beliciobcardoso/robo_bipede/docs/arquitetura_perna.md

# Arquitetura da perna

> Status: **em construção.** As faixas das juntas abaixo são **provisórias** — serão validadas
> na F5 (passada na simulação). As medidas da perna saem da F2.

## Juntas (por perna)

| # | Junta | Eixo | Gira para |
|---|---|---|---|
| 1 | Quadril | pitch | frente / trás |
| 2 | Joelho | pitch | dobrar / esticar |
| 3 | Tornozelo | pitch | ponta do pé para cima / baixo |
| 4 | Tornozelo | roll | inclinar para o lado |

## Batentes e limites de software

Toda junta tem **dois limites**:

1. **Batente mecânico** — um ressalto desenhado na própria peça impressa, onde as duas peças da
   junta encostam e param. Protege o servo: em queda ou empurrão o impacto vai para o plástico
   impresso, e não para o batente interno e a engrenagem plástica do SG90.
2. **Limite de software** — no firmware (e na simulação), **5° antes do batente**. O motor nunca
   é mandado além dele, então **nunca empurra o batente**. Servo forçando parado puxa ~0,7 A,
   esquenta e desgasta.

| Junta | Batente mecânico | Limite de software | Observação |
|---|---|---|---|
| Quadril pitch | −30° a +90° | −25° a +85° | +90° = coxa para frente (agachar, subir degrau) |
| Joelho | −120° a +5° | −115° a 0° | só dobra para um lado; batente em +5° impede o joelho de dobrar ao contrário |
| Tornozelo pitch | −45° a +45° | −40° a +40° | limita o agachamento mais fundo (40°) |
| Tornozelo roll | −30° a +30° | −25° a +25° | inclinação lateral para jogar o peso de um pé para o outro |

Convenção de sinal (simulação): agachar é quadril **+**, joelho **−**, tornozelo pitch **+**.

### Regras de projeto do batente

- O batente fica **na peça impressa**, nas duas partes da junta (um ressalto que encosta numa face).
- **Superfície de contato larga e parede grossa** no ponto do batente: ele leva o impacto de
  quedas. Evitar pontas finas ou cantos vivos.
- O batente **não pode depender do servo**: com o servo desmontado, a junta já deve parar no limite.
- O servo é montado com o horn **centralizado** de forma que o curso do servo (~180°) cubra a
  faixa inteira da junta com folga — o batente da peça chega antes do batente interno do servo.
- Na calibração do firmware, encostar a junta à mão no batente serve de referência para achar o
  zero de cada servo.

### O que a simulação já mostrou (modelo de caixinhas, F0)

- Agachando devagar com a regra quadril = A, joelho = −2A, tornozelo = A, o limite é o
  **software do tornozelo em 40°**, com o joelho fazendo 0,067 N·m (37 % do SG90).
- Em operação normal nenhuma junta chega ao batente.

### Deslocar o peso para o lado (resultado da F1)

O robô não tem **quadril roll**. Consequência: com os dois pés no chão, os tornozelos roll ficam
travados, e para apoiar numa perna o **corpo inteiro inclina para o lado** (~18°, faixa estável
10°–26° no modelo de 359 g com quadris a 55 mm). Quadris mais próximos reduzem essa inclinação.
**Decisão (24/10): manter 8 DOF, sem quadril roll.** O robô apoia numa perna inclinando o corpo
inteiro para o lado (andar "rebolado"). Motivos: menos peças, menos peso e menos servos para
calibrar, e na F1 o SG90 trabalhou com folga nessa postura (joelho 11 %, tornozelo roll 2–32 %).
Consequências para as próximas fases:
- a passada (F5) é do tipo "rebolado": inclina para o lado, levanta o pé de fora, dá o passo;
- a **largura do quadril** é a alavanca para reduzir a inclinação — entra na varredura da F2;
- o **tornozelo roll** é a junta que controla o equilíbrio lateral (pé de apoio).

Condições para manter a decisão:
1. **Balanço lateral em movimento:** o pico do tornozelo roll ao inclinar o corpo de um pé para o
   outro, no ritmo da passada, deve ficar abaixo de **~70 % do SG90**.
2. **Inclinação:** depois de afinar a largura do quadril (F2), a inclinação para apoiar numa
   perna deve ficar abaixo de **~20°**.
3. **Quadril modular:** o suporte do quadril e o tronco reservam espaço para um servo de quadril
   roll de cada lado, para que a mudança, se vier, não obrigue a refazer tronco, capas e fiação.

Se 1 ou 2 falhar, a decisão volta para discussão.

**Situação (24/10):**
- Condição 1 — **passa.** Com as medidas atuais (quadris 50 mm): tornozelo roll 50 % a 0,5 passo/s e 57 % a 1 passo/s. Antes, com quadris a 55 mm, dava apertado: Balanço lateral sem controle: tornozelo
  roll 53 % a 0,5 passo/s e 61 % a 1 passo/s; passa de 70 % só acima disso (85 % a 1,33 passo/s).
  O joelho chega a 69 % a 1 passo/s. Números preliminares: dependem do amortecimento do servo
  (estimado; a F3 mede) e do padrão de movimento (a F5 refina).
- Condição 2 — **passa.** Inclinação para apoiar numa perna: 14° (quadris 50 mm, tornozelo 22 mm).
- Condição 3 — entra no projeto do quadril.

## Medidas da perna

> **Aprovadas em 24/10.** Revisadas no mesmo dia no conceito do suporte (`suporte_servo.md`):
> a perna real tem ~42 mm de largura (pilha horn + servo + rolamento ao longo do eixo), então os
> quadris foram de 45 para **50 mm**, e o tornozelo pitch→roll de 12 para **22 mm**. O modelo
> `sim/models/f1_biped.xml` usa estas medidas.

| Medida | Valor | Por quê |
|---|---|---|
| Distância entre quadris | **50 mm** | Perna de ~42 mm + ~8 mm de folga: cabe capa nas duas faces. A 45 mm sobrariam ~3 mm |
| Largura da perna (estrutura) | ~42 mm | Pilha ao longo do eixo pitch: braço do garfo, horn, servo, fundo do suporte, rolamento |
| Coxa (quadril → joelho) | **45 mm** | Cabe suporte (~24 mm do eixo às costas) + garfo (~14 mm do eixo à base) + junção |
| Canela (joelho → tornozelo) | **45 mm** | Idem; coxa = canela simplifica a cinemática inversa (F5) |
| Tornozelo pitch → roll | **22 mm** | Garfo do tornozelo pitch + suporte do servo roll, numa peça única |
| Pé | **45 × 70 mm** | Largura = quadris − 5 mm, para os pés não se tocarem |
| Massa das capas | **meta 35 g, limite 50 g no total** | Validado a 1 passo/s com 50 g (tronco 20 g + 15 g por perna) |

Altura do centro do tronco em pé: ~158 mm. Massa total estimada: 359 g só com as pernas; **615 g**
com cabeça, braços de 4 servos, cintura giratória, LiPo de 55 g e capas de 0,8 mm (revisão de 25/10, ver
[arquitetura_corpo.md](arquitetura_corpo.md)). Centro do tronco em pé: ~170 mm.

Robô atual na simulação (aberto, sem controle de equilíbrio):

| Teste | Resultado |
|---|---|
| Ficar numa perna | inclinação de **14°** (faixa estável 8–20°); joelho 11 %, tornozelo roll até 40 % nas bordas |
| Balanço lateral a 0,5 passo/s | tornozelo roll **50 %**, joelho 36 % |
| Balanço lateral a 1 passo/s | tornozelo roll **57 %**, joelho 69 % |
| Levantar de 34° em 0,6 s | joelho 53 % |
