beliciobcardoso/robo_bipede/docs/medidas_horn_sg90.md

# Medidas do horn do SG90 (braço simples)

O **horn** é a pecinha de plástico branco que encaixa no eixo do servo. O garfo do suporte vai ter
um **rebaixo no formato exato do horn** — o formato é que transmite a força para a perna — então
preciso das medidas do seu.

Use o horn de **braço simples** (um braço só, como uma colher). Preencha a coluna **Medido** em mm.
Os valores "típicos" são de catálogo, só para você ter ideia da ordem de grandeza.

## Vocabulário

| Palavra | O que é |
|---|---|
| **Cubo** | a parte redonda do horn, que encaixa no eixo dentado do servo |
| **Braço** | a parte comprida que sai do cubo |
| **Furos do braço** | os furinhos ao longo do braço |

```
 vista de cima                           vista de lado

        ┌──────────────────────┐              ┌────┐  ← cubo (mais alto)
  ┌───┐ │ ○    ○    ○    ○    ○ │ ← braço      │    │━━━━━━━━━━━━━━━━━━━┓ ← braço (fino)
  │ ● │─┤                      │              └────┘
  └───┘ └──────────────────────┘
  cubo  │←─────── comprimento ──────→│
        (do centro do cubo até a ponta)
```

## Cubo

| # | Medida | Como medir | Típico | Medido |
|---|---|---|---|---|
| 1 | Diâmetro do cubo | por fora, a parte redonda | 7,0 | |
| 2 | Altura do cubo | da face de baixo até a de cima do cubo | 4,0 | |
| 3 | Diâmetro do furo do parafuso central | o furo no meio do cubo, por cima | 2,0 | |

## Braço

| # | Medida | Como medir | Típico | Medido |
|---|---|---|---|---|
| 4 | Comprimento total | do **centro** do cubo até a ponta do braço | 18 | |
| 5 | Largura do braço junto ao cubo | onde o braço encontra o cubo | 6,0 | |
| 6 | Largura do braço na ponta | na ponta | 4,0 | |
| 7 | Espessura do braço | de cima a baixo, no meio do braço | 1,5 | |
| 8 | Ponta do braço | é arredondada ou reta? | arredondada | |

## Furos do braço

| # | Medida | Como medir | Típico | Medido |
|---|---|---|---|---|
| 9 | Quantos furos | contar | 5 ou 6 | |
| 10 | Diâmetro de um furo | | 1,0 | |
| 11 | Do centro do cubo até o primeiro furo | centro a centro | 6 | |
| 12 | Entre dois furos vizinhos | centro a centro | 2,5 | |

## Montado no servo

| # | Medida | Como medir | Típico | Medido |
|---|---|---|---|---|
| 13 | Altura do horn montado | com o horn encaixado no servo: da **base do servo** até o **topo do cubo** | 32 | |
| 14 | Altura do braço montado | idem, até a face de **cima do braço** | 30 | |

As medidas **1, 2, 4, 5, 7 e 13** são as mais importantes: elas definem o rebaixo e a altura do
braço do garfo.
