beliciobcardoso/robo_bipede/docs/lista_materiais.md

# Lista de materiais e ferramentas

Marque `[x]` no que já tem. Itens **(opcional)** não bloqueiam o projeto.

Massa total: **615 g** (288 mm de altura, 17 servos com a cintura, capas de 0,8 mm de 133 g calculadas
pela forma, tronco em V — 25/10). **SG90 em todas as juntas** (decisão de
24/10): joelho e tornozelo roll ficam no limite a 1 passo/s e com folga a 0,5 passo/s — ver
[arquitetura_corpo.md](arquitetura_corpo.md).

> **Configuração: 17 servos SG90** (16 + 1 na cintura, 25/10) — por perna: quadril pitch, joelho, tornozelo pitch, tornozelo roll;
> por braço: ombro pitch, ombro roll, cotovelo, punho (gira). Mão fixa. Cabeça fixa com o sensor
> ultrassônico (aprovado em 24/10).

## Atuadores

- [ ] **Servo SG90 (clone)** — 8 — juntas das pernas (você tem 4 em mãos, 25/10)
- [ ] **Servo SG90 (clone) para os braços** — 8 — ombro pitch, ombro roll, cotovelo e punho de cada
  braço; comprar também reservas novas (as atuais não devem virar servo de braço)
- [ ] **Servo SG90 (clone) para a cintura** — 1 — gira o tronco ±45° sobre o quadril (decidido em 25/10)
- [ ] **Servo SG90 reserva** — 2 a 4 — engrenagem plástica de clone espana; ter reserva evita parar o projeto
- [X] **Horns** (braço simples e cruz) — vêm com o servo — fixação no eixo
- [X] **Parafusos do servo** (abas + horn) — vêm com o servo

## Controle e sensores

- [X] **ESP32 DevKit** — 1 — controle, MPU-6050, HC-SR04, Wi-Fi
- [X] **MPU-6050** (acelerômetro + giroscópio 3 eixos) — 1 — equilíbrio; I2C, montar no centro do tronco
- [ ] **PCA9685** (driver PWM 16 canais, I2C) — 1 — no quadril, para os 8 servos das pernas + o da cintura; os 8 dos braços vão direto no LEDC do ESP32 (divisão de 25/10, [alimentacao.md](alimentacao.md))
- [ ] **HC-SR04** (sensor ultrassônico) — 1 — na cabeça, olhando para a frente; ECHO sai em 5 V → divisor resistivo (ex.: 1 kΩ + 2 kΩ) antes do GPIO
- [ ] **ESP32-CAM** **(futuro)** — 1 — câmera na cabeça como placa separada, falando com o ESP32 principal por UART; 10 g já reservados na massa
- [ ] **INA219** (sensor de corrente/tensão I2C) **(opcional)** — 1 — medir consumo dos servos, detectar travamento
- [ ] **FSR / sensor de força no pé** **(opcional)** — 2 a 8 — detectar contato do pé com o chão
- [X] **Buzzer + LED de status** **(opcional)** — 1 — feedback de estado e bateria fraca

## Alimentação

Corrente dos servos ([alimentacao.md](alimentacao.md), 25/10): andando, pico < 2,5 A; queda ou trava
~6 A; ligar os 16 de uma vez ~12 A — o firmware liga em grupos para não chegar lá. Medir o real com o
INA219 na F3.

- [X] **Bateria 2S (7,4 V)** — 1 — **LiPo 2S ~800 mAh, ~55 g** (decidido em 24/10: com braços, as
  2× 18650 de ~95 g tiram a margem do tornozelo roll). Se o que você tem são 18650, desmarque e compre a LiPo
- [ ] **Pack 2S1P 14500 alta descarga (IMR), soldado a ponto** — 1 — para testar contra a LiPo (25/10); células sem proteção interna, marca com teste publicado, ≥ 5 A contínuos, 700–800 mAh reais (ignorar "1200 mAh")
- [X] **BMS 2S** — 1 — no pack 2S1P 14500: com balanceamento, sobrecorrente ≥ 8–10 A
- [ ] **Regulador dos servos: UBEC 5 V / 7 A genérico (2S–6S, 16 g)** **(comprado em 25/10, aguardando entrega)** — 1 — [anúncio de R$ 59](https://www.mercadolivre.com.br/ubec-5v-7a-de-2s-a-6s-p-drone-automodelo-ou-aeromodelo/up/MLBU3810590864); trocado do Pololu D24V150F5 por custo (25/10) — trilho único dos 16 servos (trilho separado para os braços não compensa a fiação extra); decidido em 25/10 no lugar do UBEC e do D24V90F5 ([alimentacao.md](alimentacao.md))
- [ ] **Regulador da lógica: módulo MP1584EN (step-down 3 A, ajustável)** **(comprado em 25/10, kit de 5, aguardando entrega)** — 1 (+4 reservas) — [anúncio](https://www.mercadolivre.com.br/5-buck-conversor-mp1584en-step-down-dc-dc-3a-ajustavel/p/MLB2088650164); no lugar do Pololu D24V10F5, por custo; ajustar em 5,0 V e travar o trimpot — ESP32, PCA9685 (lógica), MPU-6050 e HC-SR04 direto da bateria, fora do trilho dos servos: um stall derruba o trilho sem reiniciar o ESP32 (decidido em 25/10). Não tem proteção contra inversão — fica depois da chave e do conector polarizado
- [X] **Capacitor eletrolítico 470–1000 µF / 16 V** — 2 — junto ao trilho dos servos, segura queda nos picos
- [X] **Chave liga/desliga ≥ 5 A** — 1 — fica do lado da bateria, junto do fusível: conferir se aguenta 7,5 A
- [ ] **Fusível 7,5 A de ação retardada** — 1 — proteção da bateria, dimensionado pela corrente que sai dela (~5 A numa queda a 7,4 V); decidido em 25/10. O de 5 A que você tem não serve com 16 servos
- [X] **Divisor resistivo para medir bateria** (ex.: 100 kΩ + 33 kΩ) — 1 — ADC do ESP32, corte por subtensão
- [X] **Carregador balanceado 2S** (ou carregador 18650) — 1
- [X] **Conector de bateria XT30** — 1 par por pack + 1 no robô — padrão das duas baterias (25/10); balanceamento em JST-XH 3 pinos nos dois packs, para o mesmo carregador

## Cabeamento e montagem eletrônica

- [X] **Extensão de cabo de servo 15–30 cm** — 4 a 8 — servos do joelho e tornozelo até o tronco (+6 para ombro roll, cotovelo e punho)
- [X] **Barra de pinos macho 3 vias** — para placa de distribuição dos servos
- [X] **Placa perfurada** (ou PCB própria) — 1 — distribuição de alimentação + ESP32 + MPU
- [X] **Fio silicone 18–20 AWG** — trilho de potência
- [X] **Fio fino / jumpers Dupont** — sinais
- [X] **Conectores JST-XH ou Dupont + crimpador**
- [X] **Termorretrátil**
- [X] **Abraçadeiras pequenas / espiral organizadora**

## Mecânica e fixação

- [ ] **Filamento PETG** (ou PLA) — 1 rolo — PETG aguenta melhor impacto de queda
- [ ] **Rolamento 623ZZ (3×10×4 mm, aço carbono)** **(comprado, aguardando entrega)** — 8 (+2 reserva) — pivô do lado oposto ao eixo do servo; sem isso a junta fica em balanço e força o servo
- [ ] **Parafusos M3** (8, 10, 12, 16 mm) — eixos de pivô e estrutura
- [ ] **Porcas M3 autotravantes (nylon)** — pivôs não soltam com vibração
- [ ] **Arruelas M3**
- [ ] **Parafusos M2** (6, 8 mm) + porcas — fixações pequenas
- [ ] **Insertos roscados M2/M3 a quente** **(comprado em 25/10, aguardando entrega)** — kit de 400: M2 × 2–6 mm (OD 3,5) e M3 × 3–8 mm (OD 4,2) — necessário: pino do pivô e união suporte + garfo (M3), placas (M2); furo conforme o vendedor (~4,0 mm para OD 4,2), parede ≥ 1,5–2 mm em volta
- [ ] **Borracha antiderrapante para a sola** — 2 — EVA, borracha de câmara ou TPU impresso

## Ferramentas

- [ ] **Impressora 3D**
- [X] **Paquímetro**
- [X] **Multímetro**
- [X] **Fonte de bancada com limite de corrente** — primeiros testes sem risco para servos e bateria
- [X] **Ferro de solda + estanho + fluxo**
- [X] **Chaves Phillips PH00 / PH0**
- [X] **Chaves Allen / chave de boca 5,5 mm (M3)**
- [X] **Alicate de corte e desencapador**
- [X] **Testador de servo** **(opcional)** — centralizar servo antes de montar o horn
- [ ] **Analisador lógico / osciloscópio** **(opcional)** — depurar PWM e I2C

## Software

- [x] **FreeCAD 1.1** — modelagem
- [ ] **Fatiador** (OrcaSlicer, PrusaSlicer ou Cura)
- [x] **Arduino IDE 2** — já instalado; alternativa: PlatformIO
- [ ] **Biblioteca do MPU-6050** (Electronic Cats MPU6050 / i2cdevlib, com DMP)
- [X] **Git** — versionar scripts CAD e firmware
