beliciobcardoso/robo_bipede/cad/manual/servo_sg90.FCStd

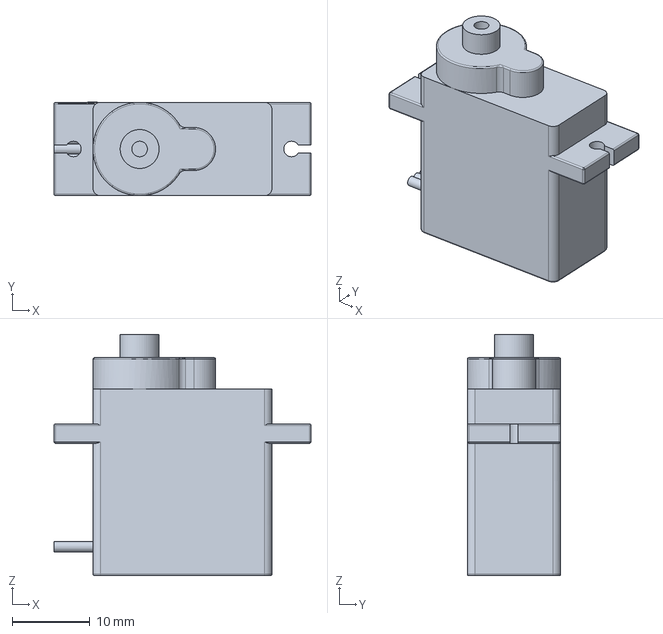
[picture p4: CAD file, 2026-10-24]
cad/manual/servo_sg90.FCStd
33.0 x 12.0 x 31.0 mm
