beliciobcardoso/robo_bipede/sim/models/meshes/servo_sg90.stl

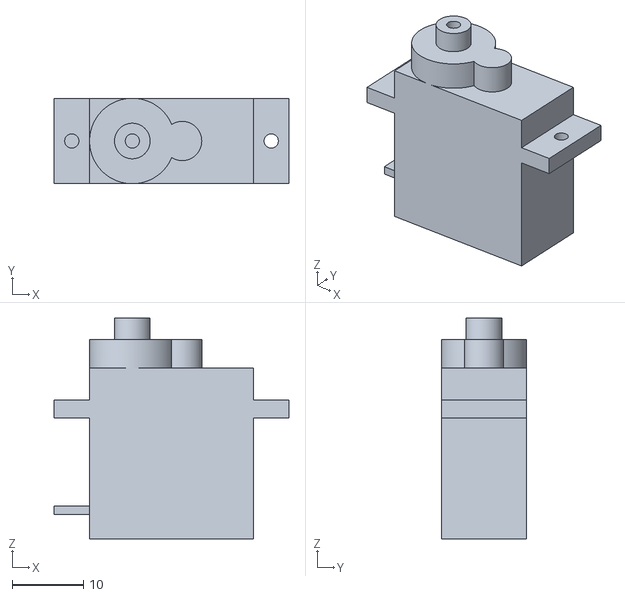
[picture p5: CAD file, 2026-10-24]
sim/models/meshes/servo_sg90.stl
33.0 x 12.0 x 31.0
