beliciobcardoso/robo_bipede/sim/models/meshes/bearing_623zz.stl

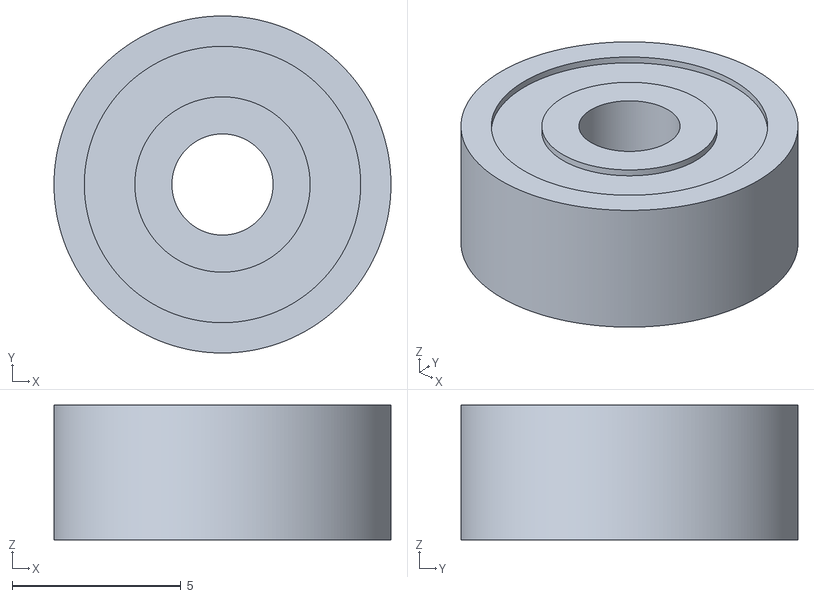
[picture p6: CAD file, 2026-10-24]
sim/models/meshes/bearing_623zz.stl
10.0 x 10.0 x 4.00
