beliciobcardoso/robo_bipede/sim/results/body_variants.csv

proporcao | parede_mm | massa_g | capas_g | altura_mm | head_pct_altura | torso_pct_altura | legs_pct_altura | dist_alpha | uma_perna | roll_teste_graus | balanco_0.5_faixa | roll_0.5_pct | joelho_0.5_pct | balanco_1.0_faixa | roll_1.0_pct | joelho_1.0_pct | levantar_joelho_pct | pior_pico_pct | passa
t68_o86_cG | 1.2 | 518 | 164 | 254 | 20 | 31 | 50 | 3.0 | -14 a -10° | 12 | 10-12 | 64 | 43 | 10-12 | 70 | 70 | 67 | 70 | True
t60_o70_cG | 0.8 | 451 | 103 | 246 | 20 | 28 | 51 | 4.5 | -16 a -8° | 12 | 10-14 | 59 | 36 | 10-12 | 62 | 68 | 62 | 68 | True
t60_o86_cG | 0.8 | 457 | 106 | 246 | 20 | 28 | 51 | 4.5 | -16 a -8° | 12 | 10-14 | 60 | 36 | 10-12 | 63 | 68 | 62 | 68 | True
t60_o70_cM | 0.8 | 449 | 101 | 238 | 18 | 29 | 53 | 6.8 | -16 a -8° | 12 | 10-14 | 59 | 36 | 10-12 | 62 | 68 | 61 | 68 | True
t60_o86_cM | 0.8 | 454 | 103 | 238 | 18 | 29 | 53 | 6.8 | -16 a -8° | 12 | 10-14 | 59 | 36 | 10-12 | 62 | 68 | 62 | 68 | True
t68_o70_cP | 1.0 | 478 | 127 | 236 | 14 | 33 | 53 | 10.3 | -16 a -8° | 12 | 10-12 | 61 | 36 | 10-12 | 70 | 70 | 63 | 70 | True
t68_o86_cP | 0.8 | 458 | 104 | 236 | 14 | 33 | 53 | 10.3 | -16 a -8° | 12 | 10-12 | 60 | 36 | 10-12 | 70 | 70 | 62 | 70 | True
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
