beliciobcardoso/robo_bipede/sim/results/f2_sweep.csv

thigh_mm | shin_mm | hip_spacing_mm | foot_width_mm | covers | mass_g | rise_knee_pct | rise_fell | tilt_needed_deg | tilt_lo | tilt_hi | stance_worst_pct | com_height_mm | shift05_pct | shift10_pct | pass_05 | pass_10 | worst_pct_at_1step
35 | 35 | 40 | 35.0 | nominais | 359 | 48.6 | False | 16.0 | -22.0 | -8.0 | 8.4 | 84.9 | 43.8 | 58.0 | True | True | 58.0
35 | 35 | 40 | 35.0 | pesadas | 409 | 50.2 | False | 16.0 | -22.0 | -8.0 | 9.2 | 83.8 | 49.8 | 65.5 | True | True | 65.5
35 | 35 | 45 | 40.0 | nominais | 359 | 48.6 | False | 16.0 | -24.0 | -10.0 | 8.4 | 84.9 | 48.8 | 63.1 | True | True | 63.1
35 | 35 | 45 | 40.0 | pesadas | 409 | 50.2 | False | 18.0 | -24.0 | -10.0 | 9.1 | 83.8 | 56.1 | 74.0 | True | False | 74.0
35 | 35 | 50 | 45.0 | nominais | 359 | 48.6 | False | 18.0 | -24.0 | -10.0 | 8.3 | 84.9 | 54.4 | 70.7 | True | False | 70.7
35 | 35 | 50 | 45.0 | pesadas | 409 | 50.2 | False | 18.0 | -24.0 | -10.0 | 9.2 | 83.8 | 61.8 | 80.0 | True | False | 80.0
35 | 35 | 55 | 45.0 | nominais | 359 | 48.6 | False | 20.0 | -24.0 | -12.0 | 8.2 | 84.9 | 60.0 | 78.4 | False | False | 78.4
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
