beliciobcardoso/robo_bipede/sim/results/f2_sweep.png

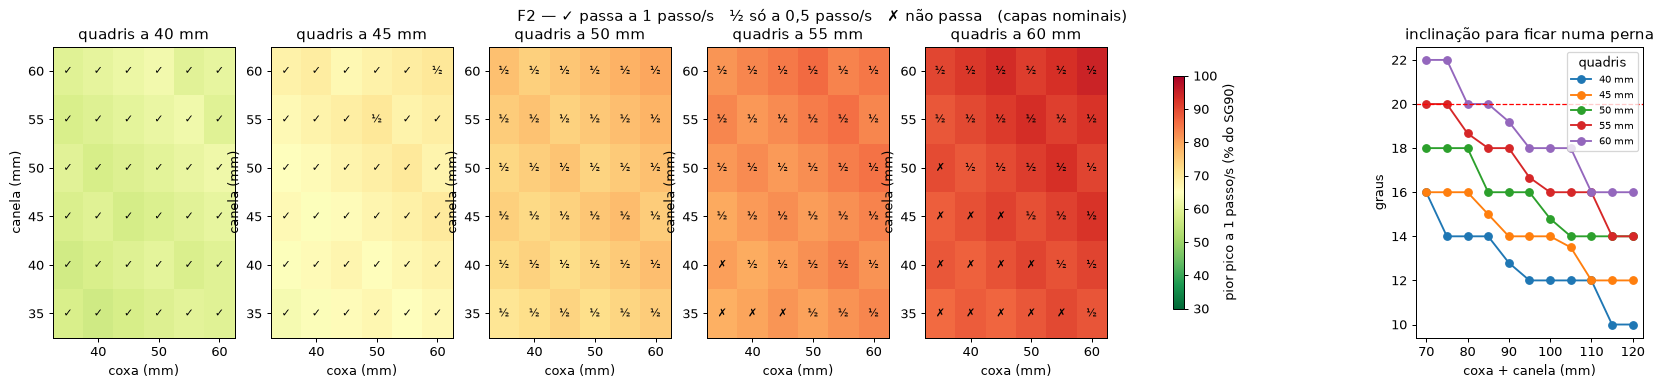
sim/results/f2_sweep.png
