beliciobcardoso/robo_bipede/(commit log)

2026-10-23 adiciona arquivos de configuração CAD, documentação e modelo do servo SG90
2026-10-23 corrige medidas do servo SG90 no documento de especificações
2026-10-23 adiciona orientações sobre o uso do FreeCAD e estrutura do CAD no arquivo CLAUDE.md; atualiza README.md com informações sobre medidas do servo SG90
2026-10-23 refatora o código do servo SG90 para utilizar funções da biblioteca cadlib e remove funções desnecessárias
2026-10-23 marca itens como concluídos na lista de materiais e ferramentas
2026-10-23 feat: add 623ZZ bearing reference model and shared cadlib helpers
    - cad/cadlib.py: CSG primitive helpers (box, cylinder, tube, cut, fuse)
    and export_part (recompute, validate single solid, write FCStd + STEP).
    servo_sg90.py already imports it, so this also fixes the build on main.
    - cad/parts/bearing_623zz.py: 3x10x4 ZZ bearing with ring lands, recessed
    shields and abutment limits (da min / Da max) for housing/spacer design.
    - Makefile: rebuild parts when cadlib.py changes.
    - README/CLAUDE.md: document cadlib and the bearing pivot convention.
2026-10-23 docs: add step-by-step PartDesign tutorial for the SG90 servo
    Hand-modelling guide for FreeCAD 1.1: Body, fully constrained sketches,
    Pad/Pocket and Attachment Offset, with values typed directly into the
    constraints (no spreadsheet). Follows the servo coordinate convention so
    the manual model matches the scripted one; output goes to cad/manual/.
2026-10-23 docs: rewrite servo PartDesign tutorial for beginners
    - Exact FreeCAD 1.1 English UI names (e.g. "New Body", "Horizontal
    Dimension", "Circle From Center"); the previous "Create body" did not exist.
    - Vocabulary (line, vertex, origin, sketch, constraint) and a screen map
    before the first step.
    - Every step says what to select, which tool, what value, and what the
    user should see; constraints in Select -> Tool -> Value tables, always
    measured vertex -> origin.
    - Dropped Attachment Offset: every sketch sits on an origin plane and
    the Pad goes straight to the final height (same resulting solid).
    - Troubleshooting table.
2026-10-24 docs: adicionar arquivo do modelo do servo SG90
    [servo_sg90.FCStd]
2026-10-24 feat: apply re-measured servo dimensions and add GPU model comparison
    - servo_sg90.py mirrors the re-measured hand-made model
    (cad/manual/servo_sg90.FCStd): body 23.0 x 12.0 x 24.0, tabs 33.0,
    holes 28.0 apart, gear bump d5.5 at 7.0, shaft screw hole d2.0.
    - Measurement sheet gains a "Remedido (24/10)" column; values in use.
    - tools/export_stl.py: fine STL from any FreeCAD object, read-only on source.
    - tools/compare_meshes.py: volumetric diff of two STLs on the GPU (CuPy) by
    vertical ray casting with exact Z crossings; per-region volumes and XY/XZ/YZ
    maps. Validated against FreeCAD's solid volume.
    - CLAUDE.md: cad/manual/ is read-only for Claude; how to run the comparison.
    - .gitign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
2026-10-24 docs: add project backlog and GPU simulation plan
    - docs/backlog.md: single checklist for the project (purchases, simulation
    F0-F8, CAD, printing, electronics, firmware), each item tagged with who
    does it; already-finished work ticked.
    - docs/simulacao.md: simulation roadmap on the local RTX 3060 - MuJoCo/MJX
    first, own algorithms only where nothing models them (SG90-clone servo
    model, CAD->MJCF bridge, gait generator, IMU filter, design sweeps).
    Status: proposal, pending approval.
    - README/CLAUDE.md: link both; backlog is the single source of progress.
2026-10-24 docs: plan snap-fit covers for the whole skeleton
    - Backlog section 3.1 "Capas encaixadas": cover-mount standard (type,
    dimensions, shared reference model), mass budget, access that covers must
    keep open (ESP32 USB, switch, charging, servo swap), wire routing,
    ventilation, covers per segment, range-of-motion review.
    - Every structural part is only done once it carries the cover mounts; leg
    architecture reserves cover envelope; F2 sweep includes cover mass; the
    tolerance test print includes the snap-fit; final weigh-in with covers.
    - CLAUDE.md: design rule for snap-fit covers.
2026-10-24 feat: set up GPU simulation environment (F0)
    - requirements.txt pins the analysis + simulation stack: MuJoCo 3.17,
    MJX with the Warp backend, JAX 0.12 (CUDA 12), CuPy, NumPy, Matplotlib.
    - sim/models/f0_smoke.xml: torso + one 4-joint leg of boxes (hip pitch,
    knee, ankle pitch, ankle roll) with SG90-like position servos, plus
    light, skybox, checker floor and camera framing so the viewer shows it.
    - sim/tools/smoke_test.py: runs the model on the CPU and in GPU batches
    (JAX and Warp backends), checks the GPU result matches the CPU and
    reports throughput. On the RTX 3060: Warp ~4.7 M steps/s with 16k robots
    (~71x one CPU core, ~20x the JAX backend), identical to the CPU result.
    - War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
    [smoke_test.py]
2026-10-24 docs: add beginner MuJoCo tutorial
    From-zero guide to the MuJoCo viewer for someone who never used a physics
    simulator: what it is, vocabulary (body, joint, actuator, torque, radian),
    a map of the window with the exact panel names, mouse/keyboard controls,
    and step-by-step tasks with what the user should see - move a joint, read
    the knee torque in Watch, and a crouch experiment with expected values
    computed by running the same simulation (0 / 0.02 / 0.04 N.m, falls at
    ~34 deg on one leg). Troubleshooting table. Backlog item to do it.
2026-10-24 feat: add MuJoCo monitor with exact crouch keys, live torque and CSV log
    - sim/tools/monitor.py: same viewer, but keys 1-4 / + / - set the crouch
    depth A exactly (hip = A, knee = -2A, ankle = A), moved at servo-like
    speed with all joints together; live knee torque vs SG90 in the terminal;
    every session logged at 50 Hz to sim/logs/*.csv so Claude can analyse it;
    dragging a Control slider switches to manual mode. --sweep runs every
    depth headless and reports torque, falls and joint-stop hits.
    - Tutorial step 5 rewritten around the monitor, with values from the sweep.
    The earlier "falls at 34 deg" came from jumping to the posture; moving
    slowly it holds up to the software limit.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
2026-10-24 feat: mechanical joint stops with software limits 5 deg inside them
    - Every joint gets a mechanical stop printed in the part plus a software
    limit 5 deg inside it, so the servo is never commanded into the stop
    (stall current, heat) while falls and pushes land on printed plastic, not
    on the SG90's internal stop and plastic gears.
    - Provisional ranges (validated later in sim F5): hip -30..+90, knee
    -120..+5 (bends one way), ankle pitch +-45, ankle roll +-30.
    - f0_smoke.xml: joint range = stop, actuator ctrlrange = software limit.
    Monitor caps the crouch at the software limits (ankle pitch, 40 deg) and
    reports "limite de software" / "NO BATENTE".
    - docs/arquitetura_perna.md (new): r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
2026-10-24 feat: generate whole-biped F1 model and drive it from the monitor
    - sim/tools/build_biped.py: BipedParams (mm, g) -> MJCF for the whole robot
    made of boxes: torso (battery, electronics, structure, cover) and two
    4-joint legs with each SG90 as a 9 g box where it will sit; joint
    stops / software limits from docs/arquitetura_perna.md; IMU site with
    accelerometer, gyro and orientation sensors; per-actuator torque sensors.
    Only feet, torso and floor collide. Default robot: 359 g, 45 mm thigh
    and shin, hips 55 mm apart. F2 sweeps will build variants in memory.
    - sim/models/f1_biped.xml: generated output (do not hand-edit).
    - monitor.py: actuators grouped by joint type (<type>_l / _r),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
    [build_biped.py, monitor.py]
2026-10-24 feat: F1 experiments - rise speed and one-leg stance on the whole biped
    - sim/tools/f1_experiments.py:
    1. stand up from a 34 deg crouch at several speeds: knee peaks 43 % of
    the SG90 in 1.2 s, 71 % in 0.6 s, 100 % in 0.3 s, falls in 0.15 s;
    2. one-leg stance: with no hip roll the ankle rolls are locked while
    both feet are down, so standing on one foot means tilting the whole
    body; starting tilted over the left foot with the right leg lifted it
    stays up between 10 and 26 deg (centre 18 deg), knee 11 %, ankle roll
    2 % (centre) to 32 % (edges).
    - docs: F1 results in simulacao.md, lateral weight-shift consequence in
    arquitetura_perna.md, tutorial step 8 (whole robo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
2026-10-24 fix: fit the monitor status line to the terminal width
    The live line was wider than an 80-column terminal and got cut before the
    torso height. It is now truncated to the terminal width and ordered by
    importance: crouch, knee % of SG90, most loaded joint, alerts (fall, joint
    stop, software limit), then tilt, torso height, mode and time. Tutorial
    example line updated.
    Verified against the user's F1 session log: static knee torques match the
    tutorial table and the 34 deg -> standing peak (43 %) matches the
    f1_experiments rise test at the same speed.
    [monitor.py]
2026-10-24 docs: record the decision to keep 8 DOF and the conditions to revisit it
    User decision (2026-10-24): keep 8 DOF, no hip roll; standing on one foot
    means tilting the whole body (~18 deg, rocking gait). Conditions to keep
    it: ankle-roll peak below ~70 % of the SG90 while rocking at walking pace,
    tilt below ~20 deg after tuning hip width (F2), and a modular hip with room
    for a hip-roll servo per side. Backlog items for the user's ticks, the
    rocking test, the review criterion and the modular hip; CLAUDE.md project
    line notes the decision.
2026-10-24 feat: lateral rocking test and physical servo damping estimate
    - sim/tools/rocking_test.py: open-loop lateral rocking at walking pace
    (shift onto one foot with both ankle rolls, far leg pushes slightly,
    lift and lower the free foot, mirror). No balance feedback. Ankle roll
    peaks 53 % of the SG90 at 0.5 step/s, 61 % at 1 step/s, 85 % at
    1.33 step/s; knee 36 / 69 / 90 %. Free foot lifts ~22 mm. Condition 1
    of the 8-DOF decision passes up to 1 step/s.
    - build_biped.py: joint damping 0.017 N.m.s/rad = SG90 stall torque /
    no-load speed (torque lost with speed), replacing a 0.05 guess that
    inflated moving-torque peaks by up to ~30 points (a 70 g swing leg read
    89 %). F1 model regen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
    [build_biped.py, rocking_test.py]
2026-10-24 feat: F2 design sweep over leg lengths, hip width and cover mass
    - sim/tools/f2_sweep.py: 360 generated robots (thigh and shin 35-60 mm,
    hips 40-60 mm apart, nominal / heavy covers) on all CPU cores in ~12 s.
    Per robot: rise from a 34 deg crouch in 0.6 s (knee peak, sim), one-leg
    stance (tilt where the stance ankle roll works least, sim), and the
    weight-shift torque from physics, m*g*(spacing/2) + I*alpha at 0.5 and
    1 step/s (open-loop rocking is too pattern-sensitive to rank designs;
    the estimate is conservative vs the sim on the F1 robot, 61 vs 53 %).
    Foot width tied to hip spacing - 5 mm so the feet never touch.
    - Hip width dominates: weight-shift torque grows linearly with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
    [f2_sweep.csv]
2026-10-24 feat: adopt the approved leg dimensions (hips 45, thigh = shin = 45 mm)
    User approved (2026-10-24) the F2 proposal: hips 45 mm apart, thigh and
    shin 45 mm between axes, foot 40 x 70 mm, covers target 35 g / limit 50 g
    total (the sweep's nominal covers were 50 g; 35 g is a stricter target).
    BipedParams defaults updated and f1_biped.xml regenerated. On the approved
    robot: one-leg tilt 14 deg (stable 8-20), rocking ankle roll 45 % at
    0.5 step/s and 50 % at 1 step/s, both 8-DOF conditions pass. Docs:
    arquitetura_perna (approved table and results), simulacao (F2 section),
    backlog, tutorial step 8, CLAUDE.md.
2026-10-24 fix: make the F2 sweep independent of the model defaults, LF line endings
    The sweep took the widest foot from BipedParams' default, so adopting the
    approved 40 mm foot silently changed the results for hips 50-60 mm. The
    rule is now explicit (min(45 mm, hip spacing - 5 mm)); rerun gives data
    identical to the original sweep. CSV written with LF line endings.
2026-10-24 docs: cover mount standard - snap-fit clip and locating pins
    - docs/capas.md (new): decision (user, 2026-10-24) to mount every cover
    with cantilever snap-fit clips plus 2 locating pins, printed in PETG,
    no glue; sliding rails and magnets compared, magnets kept as plan B
    (same mount positions). Design rules: clip beam printed flat, flex
    clearance behind it, release point, one shared clip/pin model, validate
    on the tolerance test print first.
    - Approved dimensions: clip L 8, t 1.2, width 4, hook 0.6 mm, 30 / 60 deg
    entry / retention, 0.8 mm flex clearance (strain ~1.7 %, below the ~2 %
    for repeated use of PETG; ~4 N per clip); pin d3.0 in a d3.3 hole,
    3 mm long, 0.5 mm chamfer.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
2026-10-24 fix: let part scripts import each other without re-running their build
    FreeCADCmd runs a script with __name__ equal to its module name, which is
    also what an import gives, so the old guard `__name__ in ("__main__",
    DOC_NAME)` fired on import too: a part importing another part's DIMS
    silently rebuilt and re-exported the imported part. cadlib.run_as_script()
    also checks the script path in sys.argv. Applied to servo_sg90 and
    bearing_623zz (same outputs: volumes unchanged); CLAUDE.md gotcha updated.
2026-10-24 feat: reference model of the cover mount (snap-fit clip + locating pins)
    - cad/parts/snap_clip.py, cover half: vertical side wall with the clip
    beam running horizontally (printed flat) and its hook (30 deg entry,
    60 deg retention), top flange resting on the skeleton, 2 vertical
    locating pins with tip chamfer. Prints the beam strain (1.69 %).
    - cad/parts/snap_socket.py, skeleton half: block with the hook pocket in
    the side face (depth hook + 0.2 = 0.8 mm) and the 2 pin holes in the top
    face. Shares SnapDims and the assembled-position frame; the build
    assembles both halves and fails on overlapping material (check verified
    by forcing a 0.3 mm too-shallow pocket: 2.56 mm3 reported)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
2026-10-24 feat: approve the servo bracket concept and revise leg dimensions
    - docs/suporte_servo.md (new): bracket concept approved by the user
    (2026-10-24). Every pitch joint = standard holder (servo body by its
    tabs, M3 pivot screw into an M3 insert on the servo axis, 0.5 mm spacer
    on the inner ring only) + standard yoke (arm on the horn with a horn-
    shaped recess, arm with the 623ZZ in a 9.9 mm housing and an 8.5 mm
    shoulder on the outer ring only). Segments are holder + yoke bolted
    back to back (24 + 14 = 38 mm fits the 45 mm between axes); the ankle
    block is one special part. Walls 2.0 mm, servo pocket +0.2 mm per side.
    - The real leg is ~42 mm wide along the pitch axes (horn + serv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
2026-10-24 docs: horn measurement sheet and bracket items in the backlog
    - docs/medidas_horn_sg90.md: beginner measurement sheet for the
    single-arm horn (hub, arm, holes, mounted heights) with typical values;
    the yoke's horn recess copies these.
    - Backlog: leg architecture, cover mount standard and bracket concept
    ticked; horn sheet ticked, measuring it is the user's next item; bracket
    work split into holder and yoke parts.
2026-10-24 feat: whole-body model with 3D preview, Alpha-like proportions and 16 SG90
    - 3D preview (make preview): servo/bearing meshes from the CAD scripts,
    bracket concept, concept covers; rendered with and without covers
    to docs/img/previa_robo.png; history in docs/previa.md
    - sim/tools/body.py is the single source of the robot: legs, torso,
    head (HC-SR04 + camera reserve), arms with 4 joints (shoulder pitch,
    shoulder roll, elbow, wrist rotation; fixed hand), servo per joint
    (SG90 everywhere), LiPo 2S
    - cover masses computed from their shape: each cover encloses its own
    skeleton (gap + wall x PETG density + 15 %); cover_check.py lists
    skeleton parts sticking out
    - arm width rule: every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
    [bearing_623zz.stl, body_variants.csv, servo_sg90.stl]
2026-10-25 feat: torso contents model, servo-rail current budget and power decisions
    - body.py: TORSO_PARTS catalogue (battery, regulators, ESP32 board, PCA9685,
    power board, IMU, switch) replaces the lump electronics mass; torso grown to
    76 x 78 x 68 mm with a mild V; shoulder pitch body direction parameter
    - torso_layout.py: voxel packing search of the torso contents between the
    servos (battery placement preference still a TODO, layout not filled yet)
    - current_budget.py: rail current per scenario from the sim torques; walking
    stays under 2.5 A, a fall ~6 A, unstaggered power-on ~12 A
    - Power decisions (2026-10-25): Pololu D24V150F5 15 A for the servos,
    separate D24V10F5 for the logic, 7.5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
    [body.py, build_biped.py, current_budget.py, render_preview.py, torso_layout.py]
2026-10-25 feat: pelvis with waist yaw, torso/pelvis electronics split and torque cuts
    - Pelvis split from the torso: the torso turns +-45 deg on a waist yaw
    joint (17th SG90, servo in the pelvis over the hip servos); IMU on the
    pelvis; tilt measured from the torso up axis so the yaw does not count
    - BODY_PARTS with a seat per part: ESP32 in the torso (arm servos on LEDC),
    power, IMU and the leg/waist PCA9685 in the pelvis; only the servo rail,
    logic 5 V and I2C cross the waist
    - torso_layout.py works per seat (--seat pelvis), reports parts with no
    stored position, and checks with the same voxel rounding as the search;
    torso 50 x 78 x 45 holds the ESP32, pelvis 76 x 92 x 52 holds the rest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
2026-10-25 feat: V torso (variant B), re-simulated numbers and refreshed preview
    - Torso 50 x 62 x 50 mm with 96 mm shoulders: cover chest/waist 1.52, in the
    range of the user's reference silhouettes; ESP32 re-placed in TORSO_LAYOUT
    - 615 g, 288 mm: one-leg stance 66 %, rise at 1 rad/s knee 79 %; open-loop
    rocking now shifts the weight only with +-9 deg roll, so rocking_test and
    current_budget default to 9 deg
    - Docs: new numbers in simulacao.md / arquitetura_corpo.md, stale masses and
    dimensions synced, preview image and history line, correction plan updated
    [body.py, current_budget.py, rocking_test.py]
2026-10-25 docs: add the waist servo to the BOM and record the 4 servos in hand
2026-10-25 docs: heat-set insert kit bought and now required
2026-10-25 feat: generic 5 V / 7 A UBEC for the servo rail instead of the Pololu D24V150F5
    Cheaper (R$ 59), 16 g; thin margin over the ~6 A fall case, relies on the
    staggered power-on. Pelvis layout re-searched for its shape; model 621 g.
2026-10-25 docs: UBEC 5 V / 7 A bought, waiting delivery
2026-10-25 docs: wiring diagram with pin map, waist wires and power path
    Figure generated by tools/wiring_diagram.py from the same pin map as the
    tables in docs/esquema_eletrico.md. Seven wires cross the waist (3.3 V for
    the I2C pull-ups and the VBAT sense line were missing from the count).
    [wiring_diagram.py]
2026-10-25 feat: MP1584EN buck module for the logic rail instead of the Pololu D24V10F5
    Bought (kit of 5); set to 5.0 V and lock the trimpot. Pelvis layout
    re-searched for its size, wiring diagram and docs updated; model 622 g.
